jessicaKH/RSerre/README.md

# AmicaPlant : serre connectée d'intérieur / automated and connected indoor greenhouse

Notre projet est une serre d'intérieur connectée et automatisée, donc qui permet de faire pousser des plantes, donc des aromates, des fleurs, ou simplement des plantes décoratives en intérieur mais en contrôlant tous les paramètres et l'entretien de la plante de façon connectée. 
Nous travaillons principalement sur le contrôle de trois paramètres physiques : l’humidité de l'air et de la terre, la température de la serre et la luminosité. Nous trouvons l'idée particulièrement intéressante parce que ce n’est pas rare d'acheter une plante qui meurt très vite parce qu’on l'oublie ou qu’on ne sait pas en prendre soin, et cette serre permet de le faire mais avec un peu d’assistance parce qu’elle est automatisée, même si on peut manuellement décider de l'arrosage, de la ventilation et ainsi de suite.

Our project is a connected and automated indoor greenhouse that allows for the growth of plants, including herbs, flowers, or simply decorative plants indoors while controlling all the plant's parameters and maintenance in a connected manner. We primarily focus on controlling three physical parameters: air and soil humidity, greenhouse temperature, and lighting. We find the idea particularly interesting because it is not uncommon to buy a plant that dies quickly because it is forgotten or not properly cared for. This greenhouse allows for plant growth with some assistance as it is automated, although manual control of watering, ventilation, and other parameters is also possible.

[Présentation de notre projet à Polytech Nice Sophia / Presentation of our project at Polytech Nice Sophia](https://www.youtube.com/watch?v=EP37zoyjy-4&t=2m19s)

<br>

Vidéo de démonstration / Demo video :

https://user-images.githubusercontent.com/120385973/229153455-96303928-5e5a-4530-bb52-85f10c074047.mp4

Credits for the images used in the app :
https://www.freepik.com/free-vector/cute-collection-cactus-watercolor_10122442.htm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
Image by Vectonauta on Freepik
https://icons8.com/icons/set/button--static--c-b3d9be
