jessicaKH/RSerre/Rapports de séance - Amel Aloui/Rapports.md

Ce répertoire contient mes rapports de séance pour le projet Arduino PeiP2.
