jessicaKH/RSerre/Rapports de séance - Amel Aloui/Séance n°8 - ALOUI.pdf

### Projet Arduino : AmicaPlant (serre connectée)

### Rapport de séance n°8 (Amel Aloui)

Pendant ce)e séance, nous avons majoritairement travaillé sur le montage de notre serre d’intérieur.
Nous avons penser à faire une plateforme pour maintenir le pot de notre plante, afin qu’il ne puisse pas bouger lorsque nous transportons notre serre par exemple, donc un premier temps nous avons fait le patron sur boxes que nous avons importé sur inksape, que voici :

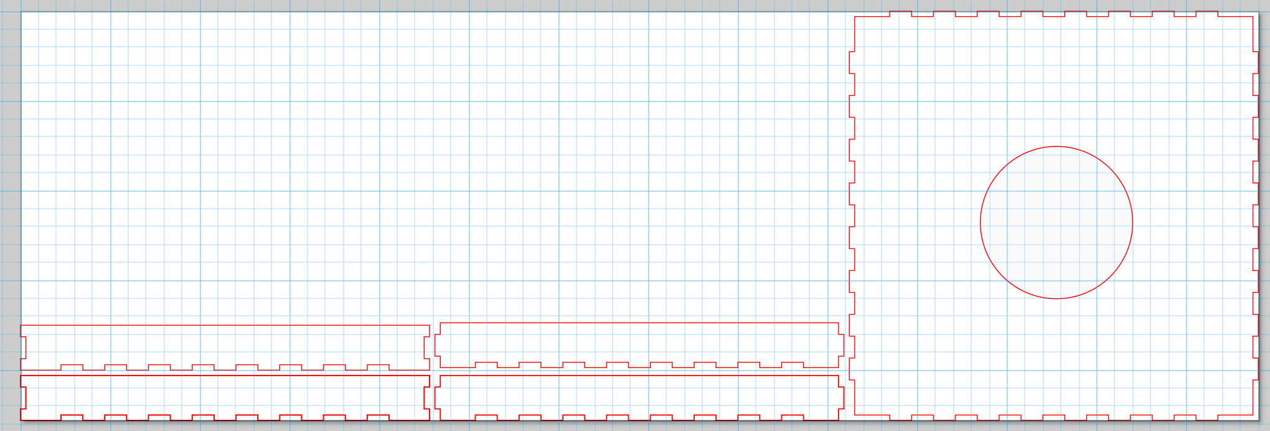
[picture p11: figure]

Puis nous l’avons imprimer au laser en 3mm au FabLab, voici le résultat :

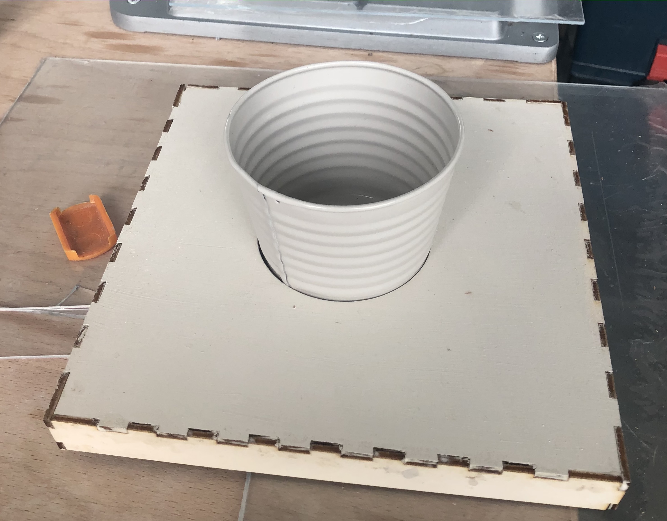
[picture p12: figure]

Par ailleurs, nous avons collés les plaques de Plexiglas (20,8cmx24,8cm) à la serre à l’aide d’un pistolet à colle.
Nous avons ensuite crée une plate-forme qui se situe au dessus de la plante, avec un trou pour faire passer la tête de l’arrosoir.

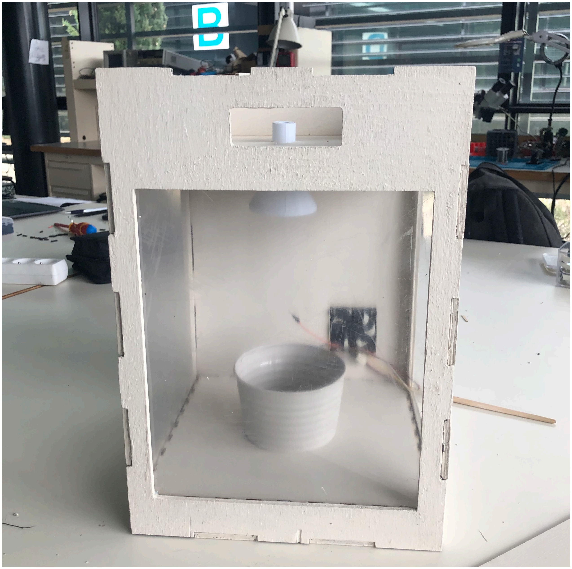
[picture p13: figure]
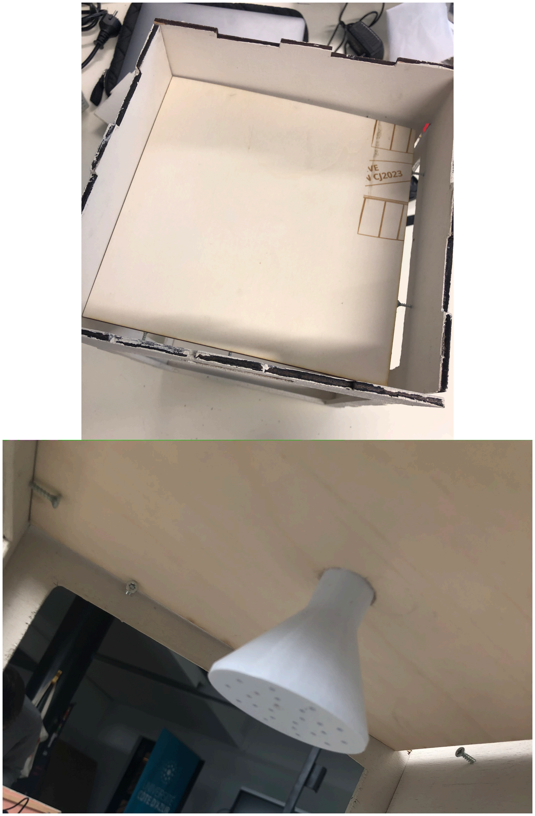
[picture p14: figure]

Nous avons ensuite fixé la dernière plaque de Plexiglas qui sert de porte afin d’accéder à l’intérieur de la serre, pour changer la plante par exemple.
Nous avons alors fixé à la perceuse une charnière reliant la serre à la porte de Plexiglas, nous comptons fermer ce)e porte à l’aide de deux aimants. Nous allons également crée une peOte poignet de porte en 3D.

Nous avons du également faire une boîte qui sera fixé à l’arrière de la serre et qui conOendra le réservoir d’eau pour arroser la plante, nous avons fait le patron de la boîte sur boxes que nous avons importé sur inksape, une fois imprimé au laser nous l’avons peint de la même couleur de la serre :

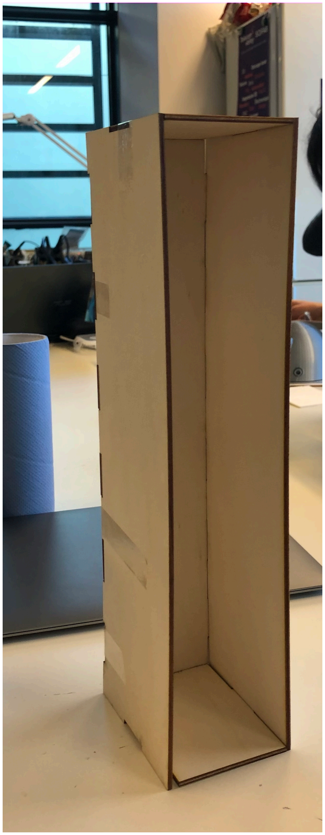
[picture p15: figure]
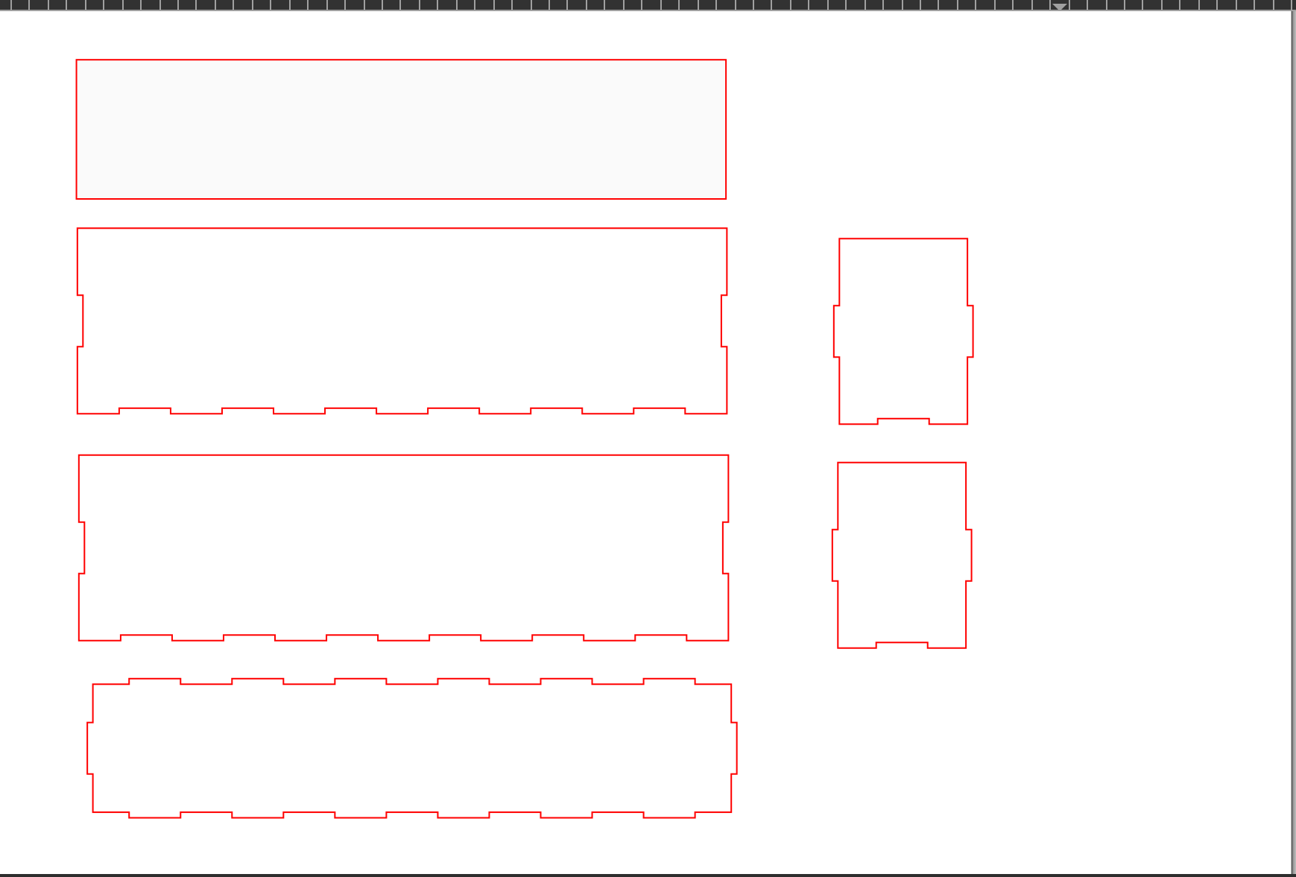
[picture p16: figure]

Nous avons alors aussi fait une porte à l’aide d’une charnière qui pourra fermé la réserve d’eau. Nous uOliserons la même poignet de porte pour ce)e boîte.
Nous avions pas prévu de passer autant de temps sur le montage de la serre, nous aurions aussi dû tester notre montage électronique final en regroupant tout nos capteurs (température, lumière, terre) et en essayant de trouver une soluOon pour contrôler le débit de la pompe à eau avec un potenOomètre, car actuellement nous contrôlons le débit de de la pompe avec des delays sur Arduino.
