jessicaKH/RSerre/Rapports de séance - Amel Aloui/Séance n°1 - ALOUI.pdf

### Projet Arduino : AmicaPlant (serre connectée)

### Rapport de séance n°1 (Amel Aloui)

Pour notre serre nous aurons besoin de connaître les paramètres physiques suivants :
- la luminosité
- l'humidité dans la terre
- l’humidité dans l’air
- la température

La serre connectée doit perme>re de gérer de façon automaBque tous ces paramètres physiques qui sont nécessaires au développement d’une plante.

Pour cela, nous devons aussi connaître à quel niveaux doivent être ces paramètres.

### Pour la luminosité

Elle doit être à 500lux (le "lux" est l'unité de mesure de la lumière), nous devons alors mesurer la luminosité dans la serre pour pouvoir ajuster l’éclairage de la plante lorsqu’elle est inférieur à 500lux. Nous avons à disposiBon une photorésistance Silonex, NORP qui va faire office de capteur de luminosité.

C’est un composant dont la valeur change en foncBon de la lumière qu'elle reçoit.

Pour réaliser le montage, le matériel nécéssaire est :
- une carte Arduino Uno,
- une photorésistante Silonex, NORP,
- une résistance,
- des fils ,

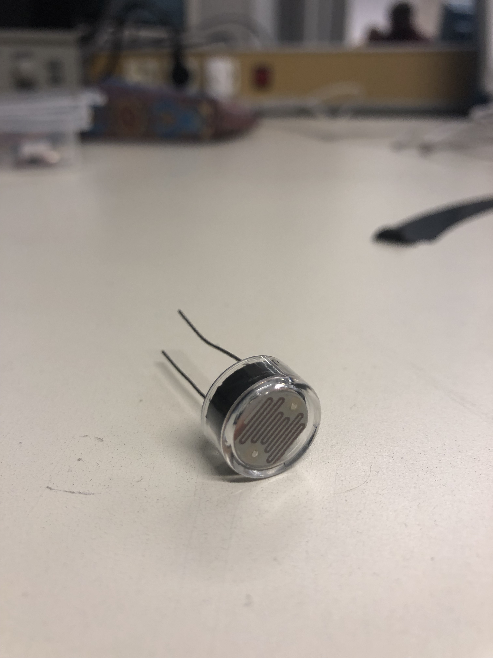
[picture p27: figure]

Résistance photosensible,
Silonex, NORP

- une plaque d’essai.

Schéma du montage :
Le code pour afficher la valeur de la lumière peut être le suivant : int valeur=0;
void setup() {
Serial.begin(9600);
}
void loop() {
valeur = analogRead(A0); // Mesure la tension sur l’entrée A0 Serial.println(valeur);
delay(250);
}

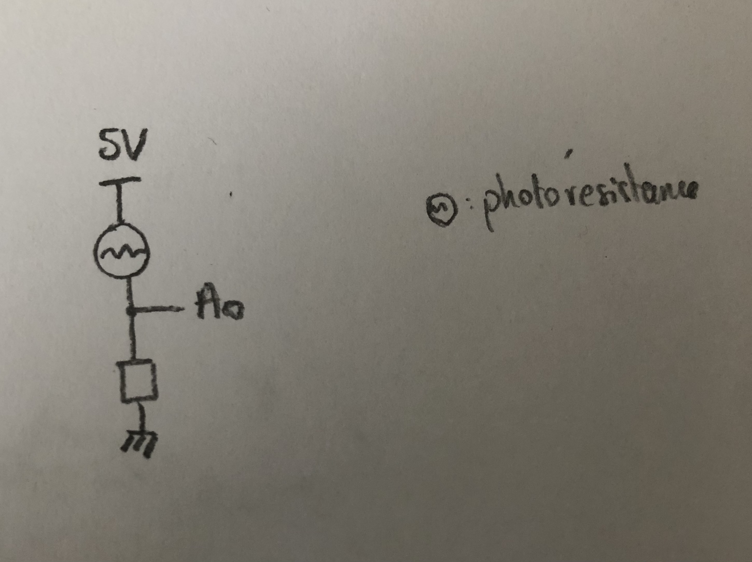
[picture p28: figure]

(à tester à la prochaine séance)

Avec des recherches, j’ai compris que le moniteur d’arduino affiche des valeurs de luminosité sans unité (lumière allumée, noir complet,…), or que nous souhaitons avoir une mesure en lux, il va falloir ‘’calibrer’’ la photorésistance et intégrer les données de calibraBon dans le code.

### Pour l’humidité de la terre

Nous avons à disposiBon capteur humidité du sol YL-69.

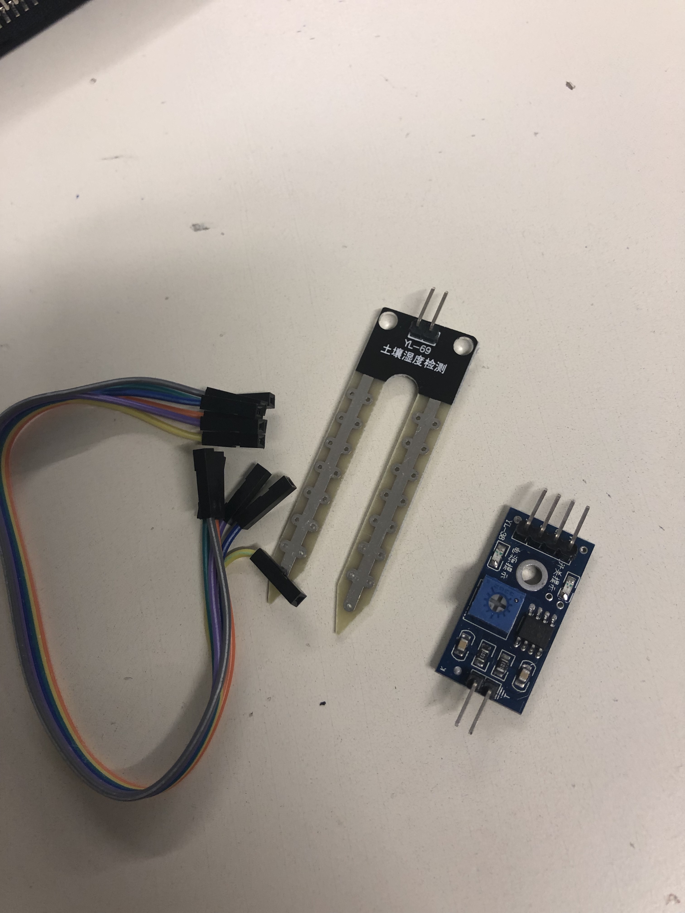
[picture p29: figure]

capteur humidité du sol YL-69
