jessicaKH/RSerre/Présentation AmicaPlant.pdf

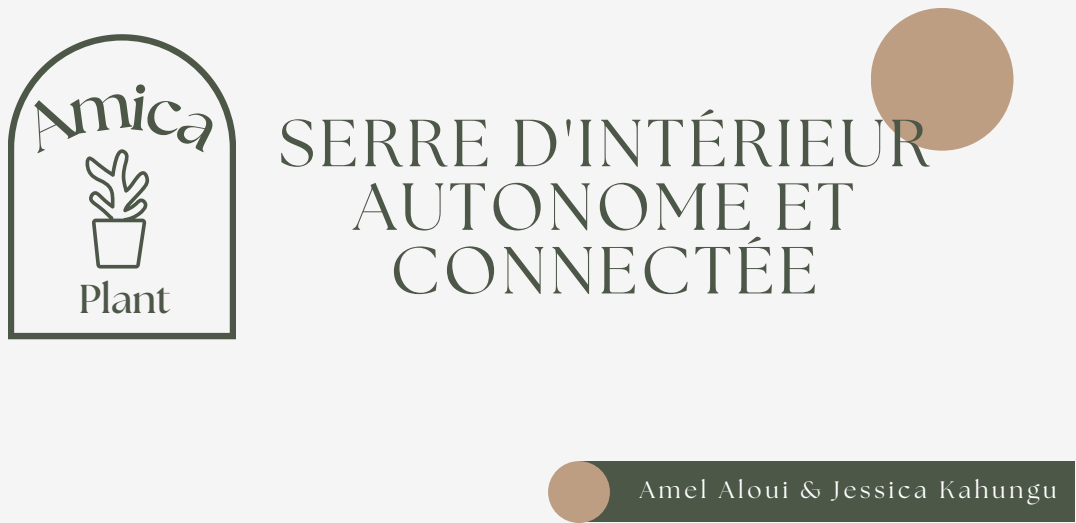
[picture p38: page 1]
SERRE D'INTÉRIEUR AUTONOME ET CONNECTÉE; Amica; Plant

# SOMMAIRE

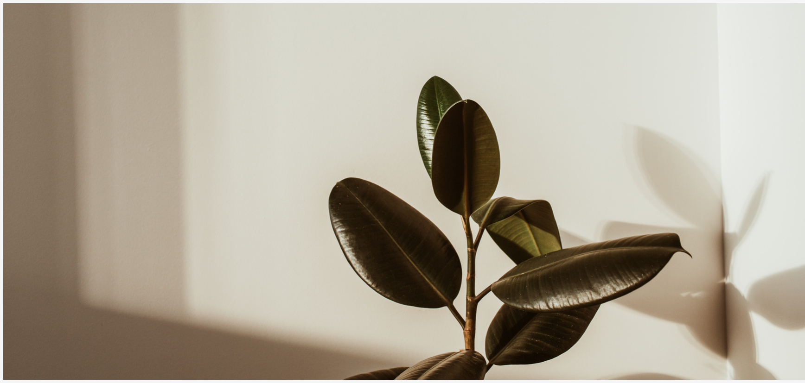
[picture p39: figure]

Objectifs et motivations

Conclusion

Démonstration

Fonctionnement : capteurs, code, application et

circuit

A
P

Matériel

Organisation

# OBJECTIFS & MOTIVATIONS

## Qui ? Pour un utilisateur qui veut garder en

vie une plante, faire pousser des aromates,

## ou même étudier la croissance d’une plante

## en ayant le contrôle sur les différents

paramètres physiques.

## Pourquoi ? Aider l'utilisateur à prendre soin

## de sa plante

A

A

# DÉMONSTRATION

# https://youtu.be/IywrB6E-ej0

# F o n c ti o n n e m e n t

Capteur d'humidité et de

température de l'air DHT22

Capteur d'humidité du sol YL-69 | Capteur de luminosité (photorésistance LDR)
Ventilateur | Pompe péristaltique | Bandes de lumières LED

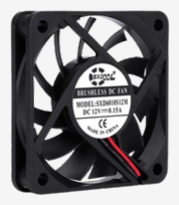
[picture p40: figure]

A

# CODE ARDUINO

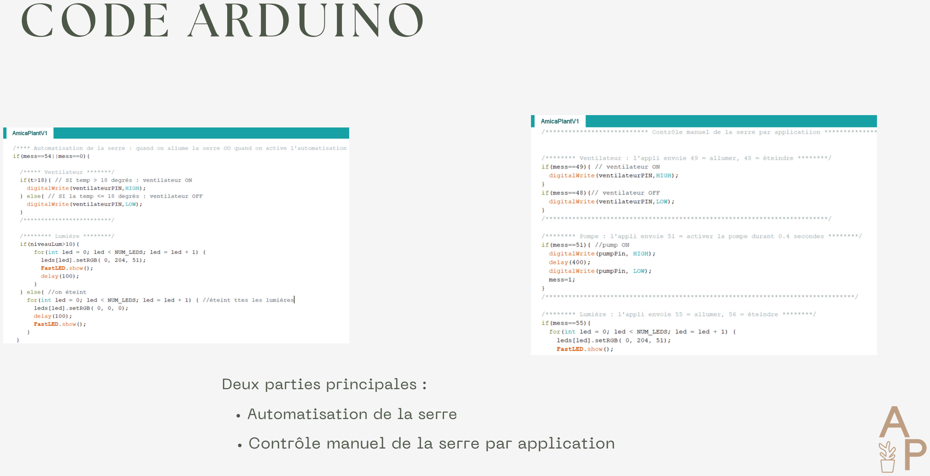
[picture p41: page 6]

### Automatisation de la serre

### Contrôle manuel de la serre par application

### Deux parties principales :

A

A

# APPLICATION AMICA PLANT

### Créée grâce au MIT App Inventor

### Programmation par blocs

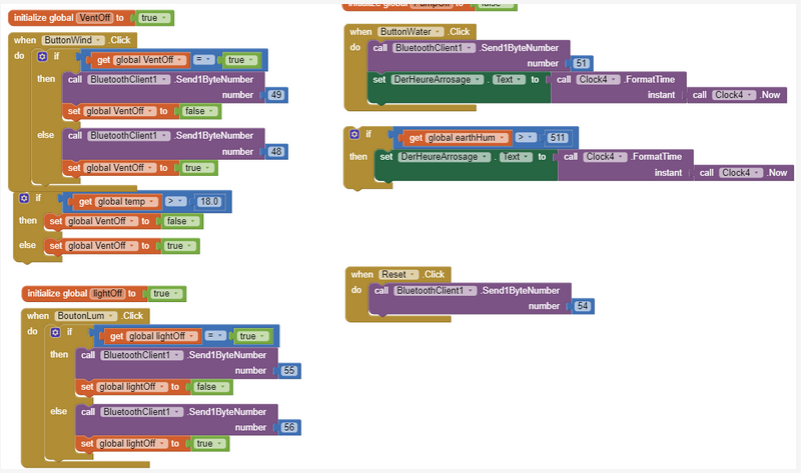
[picture p42: figure]

## Blocs utilisés pour contrôler les boutons

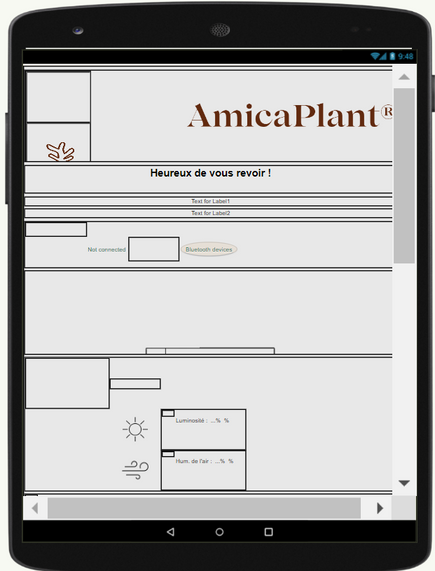
[picture p43: figure]

## Interface pour personnaliser l'aspect

## visuel de l'application

# RÉSULTAT FINAL

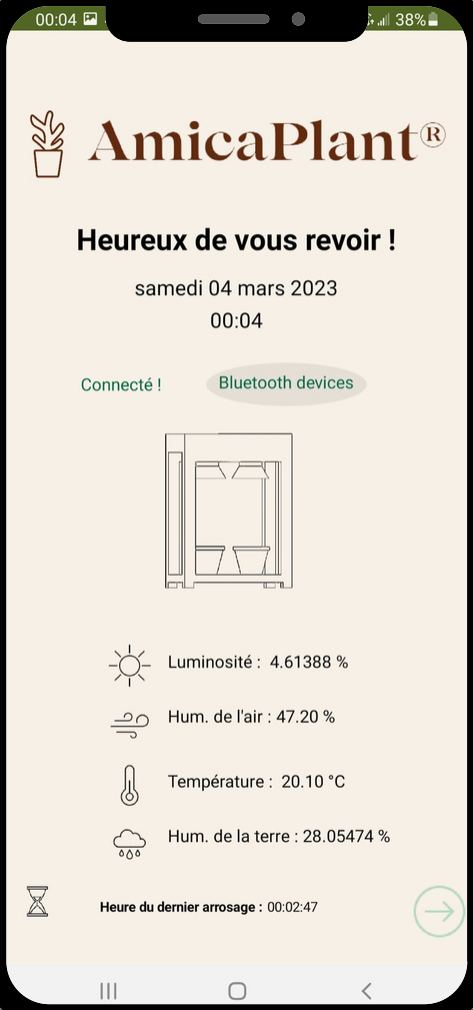
[picture p44: figure]
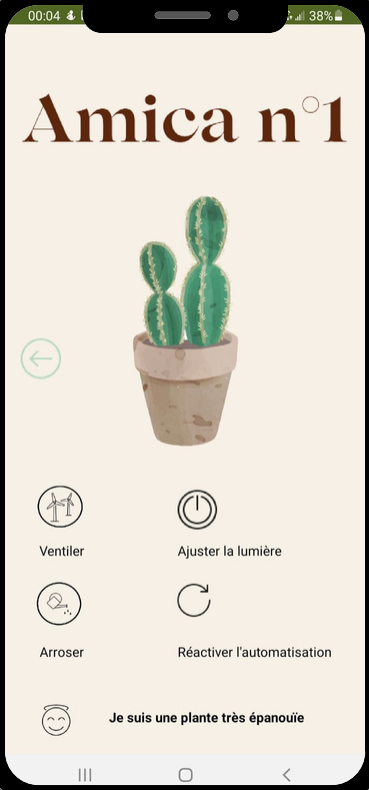
[picture p45: figure]

A

# CIRCUIT ÉLECTRIQUE

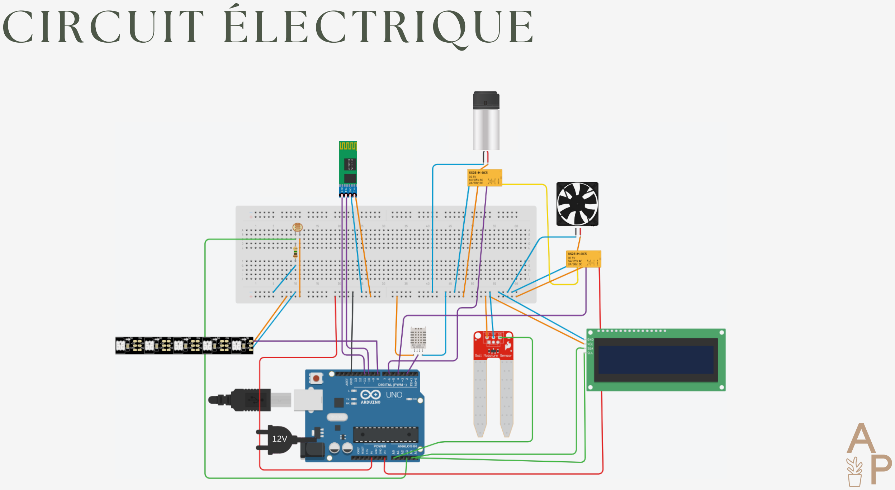
[picture p46: page 9]

A
12V

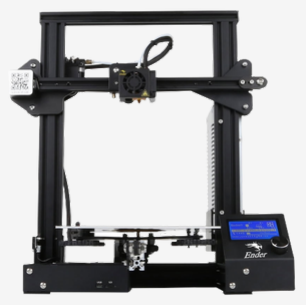
[picture p47: figure]
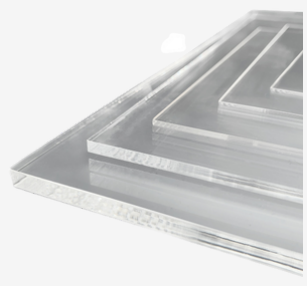
[picture p48: figure]

A

# M a t é r i e l

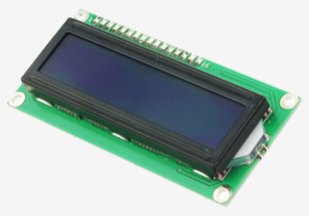
[picture p49: figure]
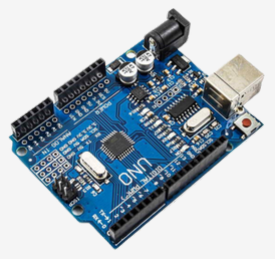
[picture p50: figure]
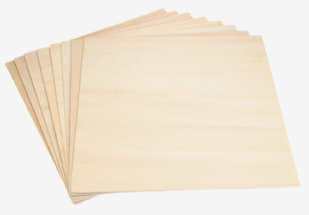
[picture p51: figure]

Ecran LCD I2C | Carte type Arduino UNO R3 | Bois (découpe laser)
Impression 3D | Plexiglas

# ORGANISATION

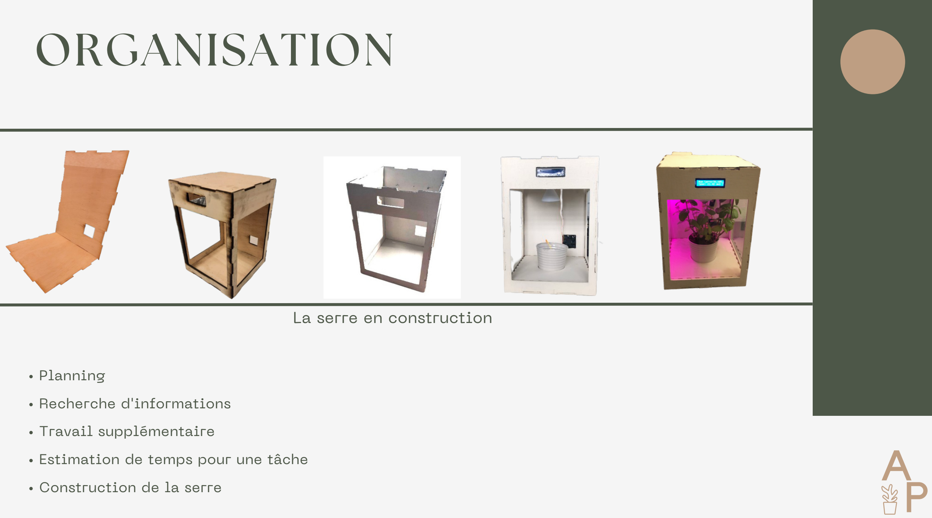
[picture p52: page 11]

A

### Planning

### Recherche d'informations

### Travail supplémentaire

### Estimation de temps pour une tâche

### Construction de la serre

## La serre en construction

A

# CONCLUSION

## Apprendre à gérer un

projet, | de | l'idée

## jusqu'au produit final

## Travail d'équipe et

## organisation

## Autonomie et savoir

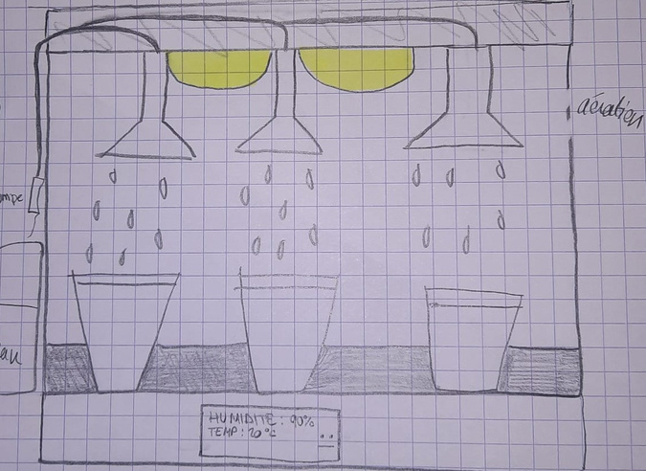
[picture p53: figure]

trouver ses erreurs | Premier schéma de notre serre
