jessicaKH/RSerre/Rapports de séance - Amel Aloui/Séance n°4 - ALOUI.pdf

Projet Arduino : AmicaPlant (serre connectée)

Rapport de séance n°4 (Amel Aloui)

Pendant ce)e séance, j’ai dans un premier temps préparer le montage avec le capteur de température, le ven8lateur et l’écran pour en faire une démonstra8on pour la minisoutenance. Le but étant que le ven8lateur s’ac8ve lorsque la température est supérieure à 25°C, tout en affichant sa valeur sur un écran LCD.

Mais le ven8lateur n’est pas puissant, car il a besoin d’une aide pour démarrer (en tournant une aile avec son doigt). De plus, on a du souder les fils du ven8lateur. J’ai testé un autre ven8lateur, qui ne fonc8onnais pas non plus, ainsi mon objec8f pour la prochaine séance est d’essayer d’autres ven8lateurs.
