jessicaKH/RSerre/Rapports de séance - Jessica Kahungu/Séance n°5 - KAHUNGU/app1.jpg

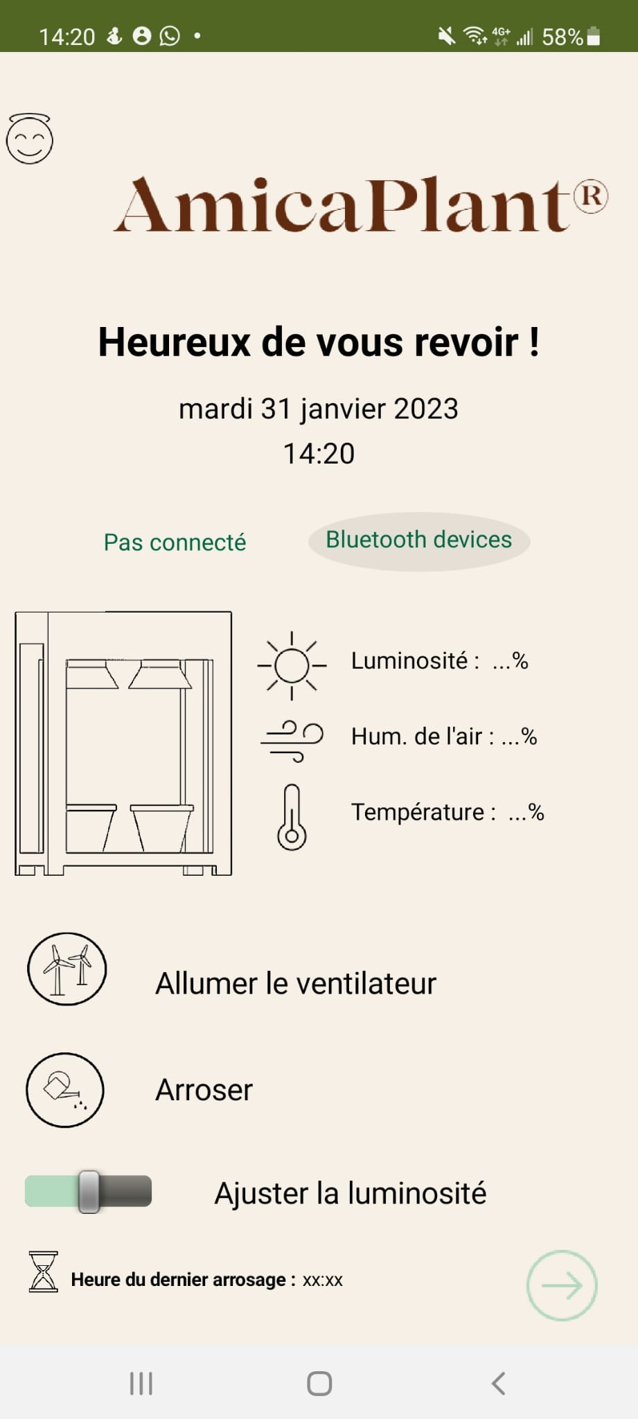
Rapports de séance - Jessica Kahungu/Séance n°5 - KAHUNGU/app1.jpg
