jessicaKH/RSerre/Rapports de séance - Jessica Kahungu/Séance n°5 - KAHUNGU/app3.jpg

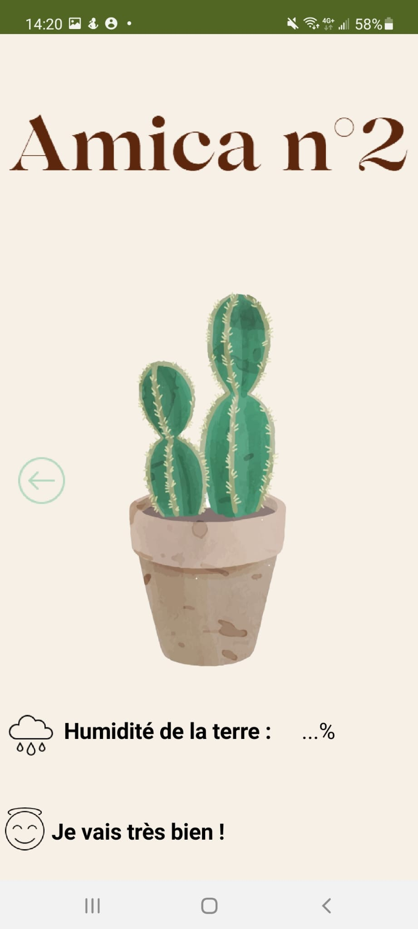
Rapports de séance - Jessica Kahungu/Séance n°5 - KAHUNGU/app3.jpg
