jessicaKH/RSerre/(commit log)

2022-12-16 Create Rapports de séance Jessica Kahungu
2022-12-16 Rename Rapport séances Jessica Kahungu/Rapports.md to Rapports de séance - Jessica Kahungu/Rapports
2023-03-13 Create Rapport final de projet - Amel Aloui et Jessica Kahungu
